rusefi/car-dash-wide/Hardware/photos/20230306_150623.jpg

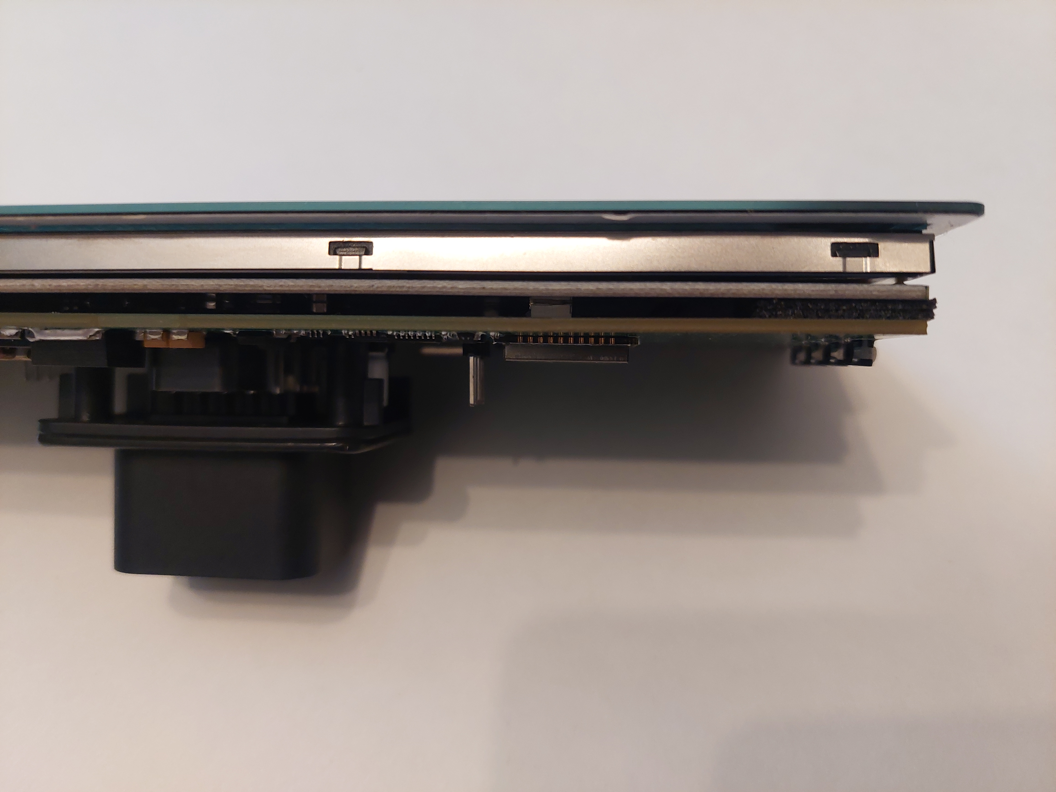
Hardware/photos/20230306_150623.jpg
