rusefi/car-dash-wide/README.md

# Digital Dash project using STM32F429II board with Surenoo 6.86" 480*1280 RGB Interface IPS LCD Module With Capacitive Touch Panel



Build on STM32CubeIDE 1.11.2 and TouchGFX 4.21.1

# Hardware

* STM32f429II
* SDRAM W9825G6KH-6I
* 2 CANBUS
* GPS ATGM336H-5N31
* ESP32-S3
* SD card
* 4 user buttons
* W2812 RGB LED connector
* on-board USB for debugging

# Initial Programming

[TC2030](https://github.com/rusefi/rusefi/wiki/Tag-Connect-TC2030) 

# Connector Part Numbers

[TE Connectivity 776262-1, 14 Contacts,  Male](https://www.mouser.co.uk/ProductDetail/TE-Connectivity/1-776262-1?qs=ZBKI5jzASZpOtA7SzySydw%3D%3D)

[TE Connectivity 776273-1, 14 Contacts,  Female](https://www.mouser.co.uk/ProductDetail/TE-Connectivity/776273-1?qs=VZ9FDhhp7SmYiN6cNJ9wsw%3D%3D)

[Datasheet](https://www.te.com/commerce/DocumentDelivery/DDEController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
)

# Connector pinout

Looking from the back of the dash

back

[Connector](https://opelpanfan.github.io/car-dash-wide/pinout/)
