rusefi/car-dash-wide/Firmware/TouchGFX/assets/images/race_dash_wide.png

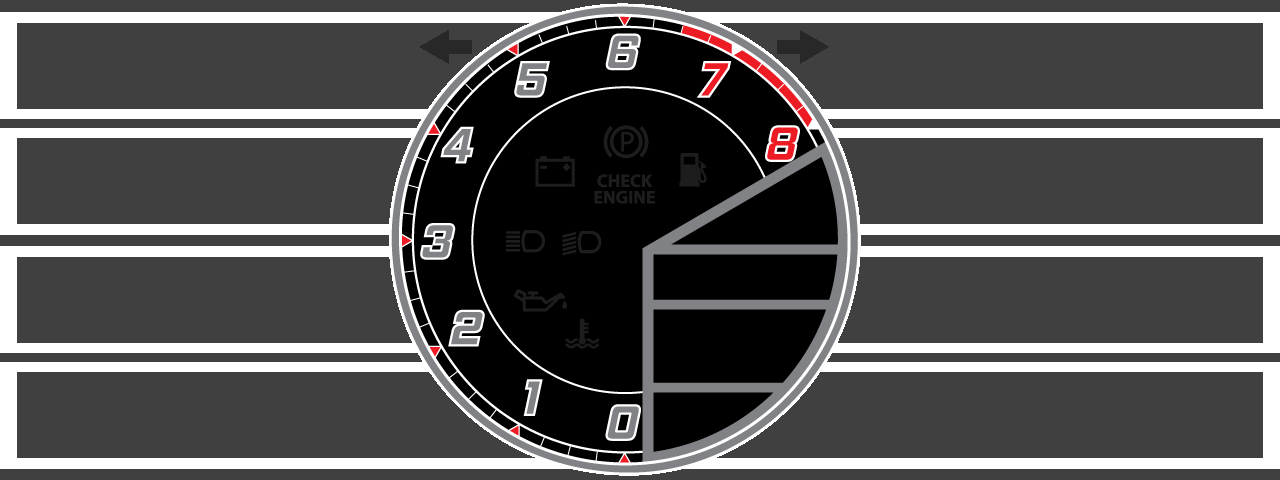
Firmware/TouchGFX/assets/images/race_dash_wide.png
