rusefi/car-dash-wide/Hardware/photos/20230228_181624.jpg

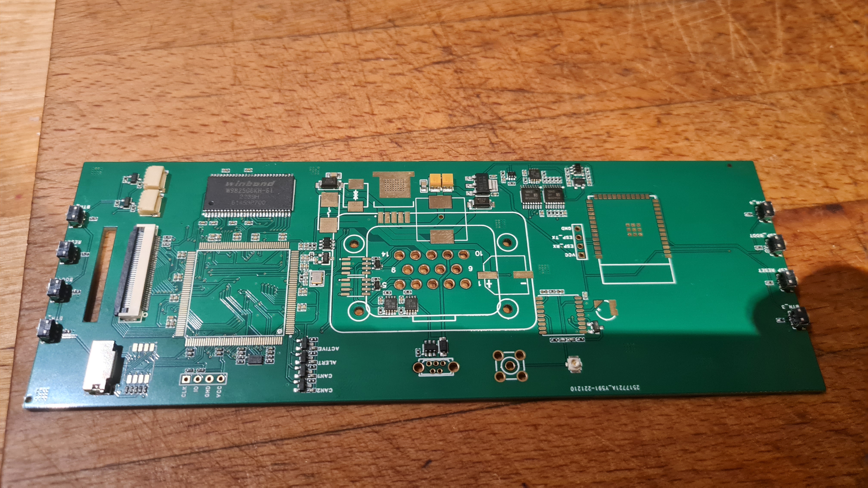
Hardware/photos/20230228_181624.jpg
