rusefi/car-dash-wide/Hardware/photos/20230228_181654.jpg

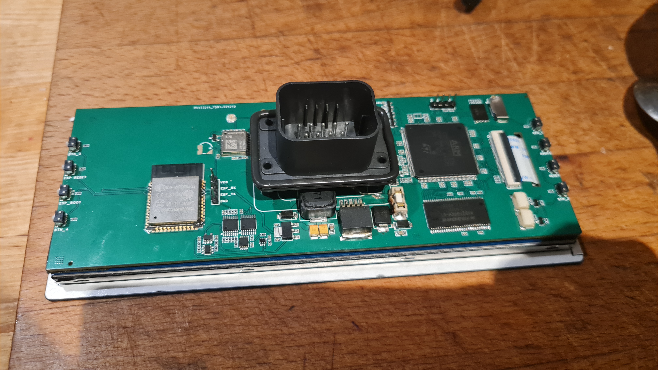
Hardware/photos/20230228_181654.jpg
