rusefi/car-dash-wide/Hardware/photos/20230228_181852.jpg

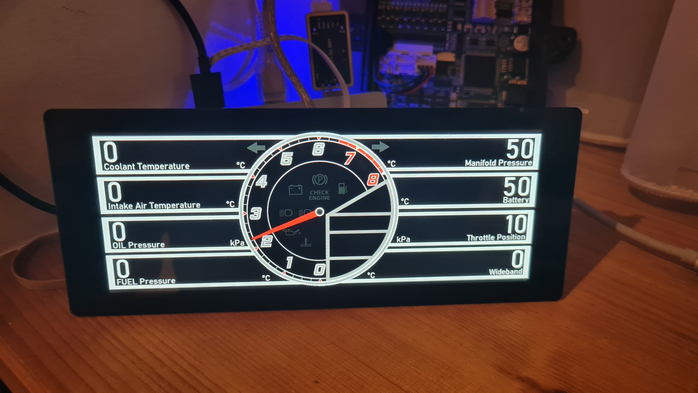
Hardware/photos/20230228_181852.jpg
