rusefi/car-dash-wide/Hardware/pinout/back.png

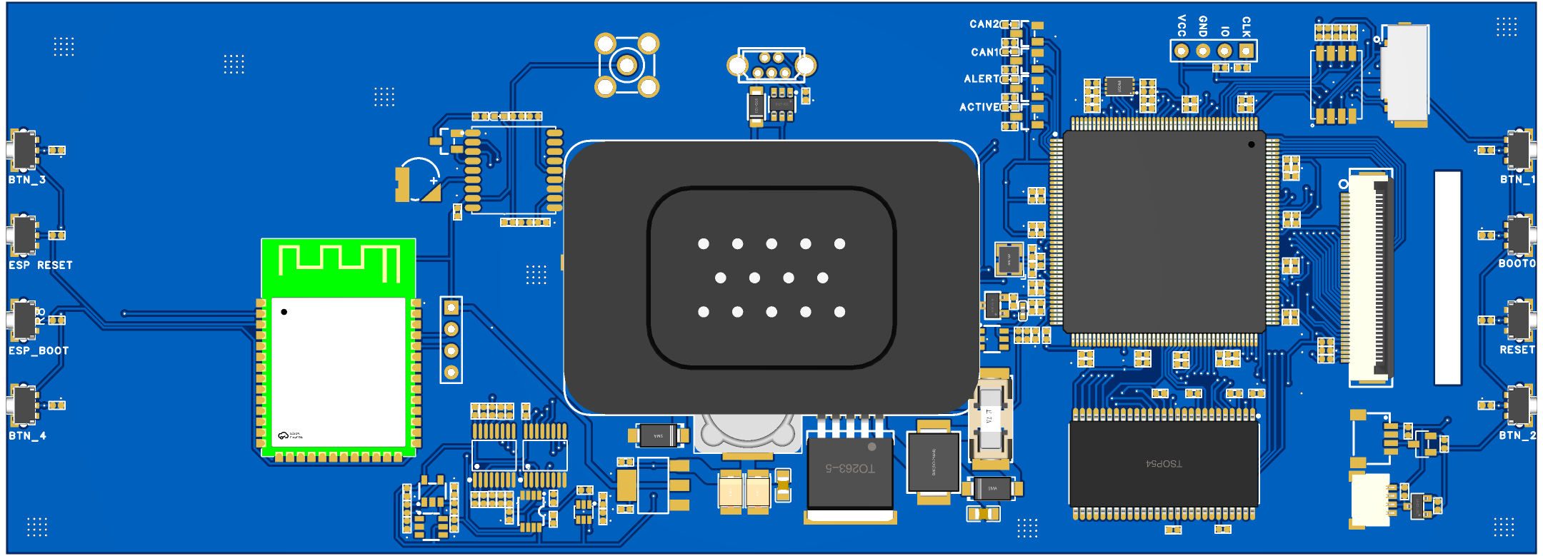
Hardware/pinout/back.png
