rusefi/car-dash-wide/Hardware/pinout/black14.jpg

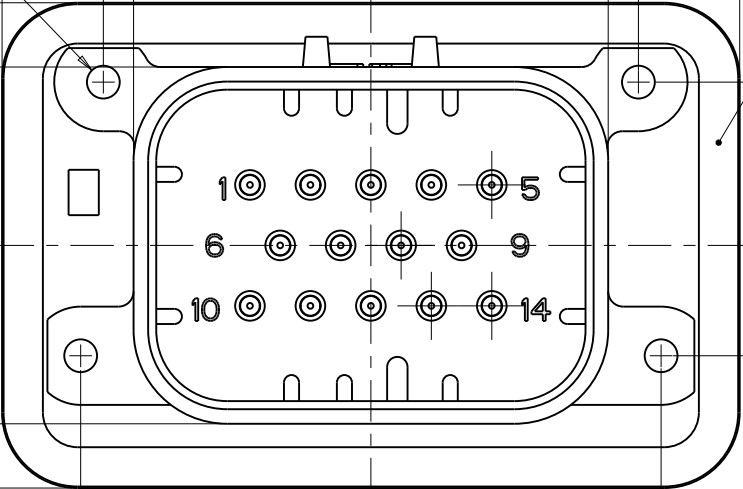
Hardware/pinout/black14.jpg
