rusefi/car-dash-wide/Hardware/export/0.1/BOM_STM32_DASH_2023-03-19.xlsx

No. | Quantity | Comment | Designator | Footprint | Value | Manufacturer Part | Manufacturer | Supplier | Supplier Part
1 | 2 | CAN03_TVS | 1,2 | SOT323_TVS |  |  |  | LCSC | C152727
2 | 2 | 100uF | C1,C10 | CAP-SMD_L3.5-W2.8 |  | TAJB107K006RNJ | AVX | LCSC | C16133
3 | 1 | 10uF | C2 | C_0402_1005METRIC |  | CL05A106MQ5NUNC | SAMSUNG | LCSC | C15525
4 | 14 | 100nF | C6,C15,C25,C38,C39,C40,C42,C49,C50,C52,C53,C56,C65,C103 | C_0402_1005METRIC |  | CL05B104KO5NNNC | SAMSUNG | LCSC | C1525
5 | 1 | 1nF | C17 | C_0402_1005METRIC |  | 0402B102K500NT | FH | LCSC | C1523
6 | 1 | 1uF | C29 | C0805 |  | CL21B105KBFNNNE | SAMSUNG | LCSC | C28323
7 | 1 | 100nF | C32 | C0805 |  | CC0805KRX7R9BB104 | YAGEO | LCSC | C49678
8 | 1 | 470uF | C33 | CAP-SMD_BD10.0-L10.3-W10.3-RD |  | VE-471M1E1010-TR0 | Lelon | LCSC | C249931
9 | 18 | 10nF | C34,C37,C47,C48,C59,C63,C64,C68,C73,C74,C75,C78,C84,C88,C91,C118,C123,C133 | C_0402_1005METRIC |  | CL05B103KB5NNNC | SAMSUNG | LCSC | C15195
10 | 17 | 4.7uF | C35,C66,C70,C71,C77,C79,C80,C81,C86,C87,C89,C127,C128,C129,C130,C131,C132 | C_0402_1005METRIC |  | CL05A475MP5NRNC | SAMSUNG | LCSC | C23733
11 | 2 | 20pF | C36,C72 | C_0402_1005METRIC |  | 0402CG200J500NT | FH | LCSC | C1554
12 | 2 | 2.2uF | C43,C44 | C_0402_1005METRIC |  | CL05A225MA5NUNC | SAMSUNG | LCSC | C159814
13 | 2 | 0 | C45,C46 | C_0402_1005METRIC |  | ?
14 | 1 | 1uF | C69 | C_0402_1005METRIC |  | CL05A105KA5NQNC | SAMSUNG | LCSC | C52923
15 | 1 | 33nF | C113 | C_0402_1005METRIC |  | 0402F333M500NT | FH | LCSC | C1585
16 | 1 | TF-021B-H265 | CARD2 | TF-SMD_TF-021B-H265 |  | TF-021B-H265 | SOFNG(硕方) | LCSC | C498185
17 | 2 | SM04B-SRSS-TB (LF)(SN) | CN1,CN2 | CONN-SMD_4P-P1.00_SM04B-SRSS-TB-LF-SN |  | SM04B-SRSS-TB (LF)(SN) | JST Sales America | LCSC | C160404
18 | 1 | 776262-1 | CN10 | CONN-TH_776262-1 |  | 776262-1 | TE Connectivity(美国泰科) | LCSC | C498489
19 | 1 | SM15T15CA | D2 | SMC_L6.9-W5.9-LS7.9-BI |  | SM15T15CA | STMicroelectronics | LCSC | C133713
20 | 2 | SS54_C22452 | D17,D20 | SMA_L4.4-W2.8-LS5.4-R-RD |  | SS54 | MDD | LCSC | C22452
21 | 1 | B5819W_C8598 | D23 | SOD-123_L2.8-W1.8-LS3.7-RD |  | B5819W | CJ | LCSC | C8598
22 | 1 | USBLC6-2SC6 | D24 | SOT-23-6_L2.9-W1.6-P0.95-LS2.8-BR |  | USBLC6-2SC6 | STMicroelectronics | LCSC | C7519
23 | 1 | 01550900M | FH1 | FUSE-SMD_L9.8-W5.0 |  | 01550900M | Littelfuse | LCSC | C108518
24 | 1 | LM1117IMPX-3.3 | IC3 | SOT223 |  |  |  | LCSC | C6186
25 | 1 | 470uH | L1 | IND-SMD_L12.5-W12.5 |  | SWRB1207S-471MT | Sunlord | LCSC | C397820
26 | 1 | 100Ω | L3 | L0402 |  | CBW100505U101T | FH | LCSC | C124089
27 | 1 | 47nH | L5 | R_0402_1005METRIC |  | SCC1005C47NJSP | Sunltech Tech | LCSC | C219549
28 | 5 | LED | LED1,LED2,LED3,LED4,LED28 | LED0402-RD |  |  |  | LCSC | C130722
29 | 2 | Header-Female-2.54_1x4 | P1,P3 | HDR-4X1/2.54 |  | Header-Female-2.54_1x4 | ReliaPro | LCSC | C124413
30 | 1 | FPCConnector 40PIN 0.5MM | P2 | FPC-SMD_40P-P0.50_FG-H2.0-40P |  | FPCConnector 40PIN 0.5MM | BOOMELE | LCSC | C9160
31 | 2 | BSS138_C400505 | Q1,Q2 | SOT-23-3_L2.9-W1.3-P1.90-LS2.4-BR |  | BSS138 | Yangzhou Yangjie Elec Tech | LCSC | C400505
32 | 1 | 0 | R1 | R_0402_1005METRIC |  | 0402WGF0000TCE | UniOhm | LCSC | C17168
33 | 36 | 10K | R2,R3,R4,R6,R7,R8,R9,R10,R12,R13,R15,R17,R18,R25,R26,R27,R28,R30,R32,R34,R35,R36,R37,R39,R40,R42,R44,R47,R127,R136,R137,R158,R205,R254,R256,R257 | R_0402_1005METRIC |  | 0402WGF1002TCE | UniOhm | LCSC | C25744
34 | 1 | 6.34K | R11 | R_0402_1005METRIC |  | 0402WGF6341TCE | UniOhm | LCSC | C45013
35 | 5 | 1K | R14,R41,R45,R46,R48 | R_0402_1005METRIC |  | 0402WGF1001TCE | UniOhm | LCSC | C11702
36 | 2 | 1M | R16,R23 | R_0402_1005METRIC |  | MCHVR02FTEY1004 | Multicomp | LCSC | C241267
37 | 5 | 4.7K | R19,R20,R21,R22,R24 | R_0402_1005METRIC |  |  |  | LCSC | C25900
38 | 1 | 10 | R29 | R_0402_1005METRIC |  | ? |  |  | C25077
39 | 2 | 120 | R31,R33 | R_0402_1005METRIC |  | 0402WGF1200TCE | UniOhm | LCSC | C25079
40 | 1 | 39 | R38 | R_0402_1005METRIC |  | 0402WGF390JTCE | UniOhm | LCSC | C25110
41 | 1 | 2.49K | R43 | R_0402_1005METRIC |  | 0402WGF2491TCE | UniOhm | LCSC | C25884
42 | 1 | 100K | R58 | R_0402_1005METRIC |  | RC0402FR-07100KL | YAGEO | LCSC | C60491
43 | 1 | 3.3K | R149 | R_0402_1005METRIC |  | 0402WGF3301TCE | UniOhm | LCSC | C25890
44 | 1 | 470K | R170 | R_0402_1005METRIC |  | 0402WGF4703TCE | UniOhm | LCSC | C25790
45 | 1 | 5.6K | R185 | R_0402_1005METRIC |  | 0402WGF5601TCE | UniOhm | LCSC | C25908
46 | 8 | SKRTLAE010 | SW2,SW3,SW4,SW5,SW6,SW7,SW8,SW9 | KEY-SMD_SKRTLAE010 |  | SKRTLAE010 | ALPSALPINE(阿尔卑斯阿尔派) | LCSC | C110293
47 | 2 | SRV05-4-P-T7 | TV1,TV5 | SOT-23-6_L2.9-W1.6-P0.95-LS2.8-BR |  | SRV05-4-P-T7 | PROTEK | LCSC | C85364
48 | 1 | XTSD04GCLGEGA | U1 | LGA-8_L6.0-W8.0-P1.27-TL |  | XTSD04GCLGEGA | XTX(芯天下) | LCSC | C2759953
49 | 1 | 74HC2G17GW,125 | U2 | SOT-363_L2.0-W1.3-P0.65-LS2.1-BR |  | 74HC2G17GW,125 | Nexperia | LCSC | C94189
50 | 2 | CD4051BPWR | U3,U12 | TSSOP-16_L5.0-W4.4-P0.65-LS6.4-BL |  | CD4051BPWR | TI | LCSC | C54587
51 | 1 | LM2596SX-5.0/NOPB | U4 | TO-263-5_L10.2-W8.9-P1.70-TL |  | LM2596SX-5.0/NOPB | TI | LCSC | C10002
52 | 3 | 74LVC1G53DP,125 | U5,U6,U16 | TSSOP-8_L3.0-W3.0-P0.65-LS4.0-BL |  | 74LVC1G53DP,125 | Nexperia | LCSC | C548378
53 | 1 | REF3033AIDBZR | U7 | SOT-23-3_L3.0-W1.7-P0.95-LS2.9-BR |  | REF3033AIDBZR | TI | LCSC | C36658
54 | 1 | MCP6001T-I/OT | U8 | SOT-23-5_L3.0-W1.7-P0.95-LS2.8-BR |  | MCP6001T-I/OT | MICROCHIP | LCSC | C116490
55 | 1 | 5-1814832-1 | U9 | RF-TH_5-1814832-1 |  | 5-1814832-1 | TE Connectivity | LCSC | C127838
56 | 1 | W9825G6KH-6I | U10 | TSOP-54_L22.2-W10.2-P0.80-LS11.8-BL |  | W9825G6KH-6I | WINBOND | LCSC | C97572
57 | 1 | SM3R3703T01U | U13 | CAP-SMD_2P-L4.8-W4.8-TR |  | SM3R3703T01U | KORCHIP(高奇普) | LCSC | C396469
58 | 2 | SN65HVD230QDR | U19,U20 | SOIC127P600X175-8N |  |  |  | LCSC | C12084
59 | 1 | STM32F429IIT6 | U22 | LQFP-176_L24.0-W24.0-P0.50-BL |  | STM32F429IIT6 | ST(意法半导体) | LCSC | C75389
60 | 1 | ATGM336H-5N31 | U31 | GPSM-SMD_ATGM336H-TR |  | ATGM336H-5N31 | ZHONGKEWEI | LCSC | C90770
61 | 1 | ESP32-S3-WROOM-1-N8 | U36 | WIFIM-SMD_ESP32-S3-WROOM-1-N8 |  | ESP32-S3-WROOM-1-N8 | ESPRESSIF(乐鑫) | LCSC | C2913198
62 | 1 | W25Q16FWUXIE | U43 | USON8_L2.0-W3.0-P0.50-BL-EP |  | W25Q16FWUXIE | WINBOND(华邦) | LCSC | C401672
63 | 5 | LMUN2211LT1G | VT1,VT2,VT3,VT4,VT14 | SOT-23-3_L2.9-W1.3-P1.90-LS2.4-BR |  | LMUN2211LT1G | LRC | LCSC | C12775
64 | 1 | 12MHz | X1 | OSC-SMD_4P-L3.2-W2.5-BL |  | X322512MSB4SI | YXC | LCSC | C9002
