rusefi/car-dash-wide/Hardware/export/0.1/SCH_6.86 DASH SCH_2023-02-28.pdf

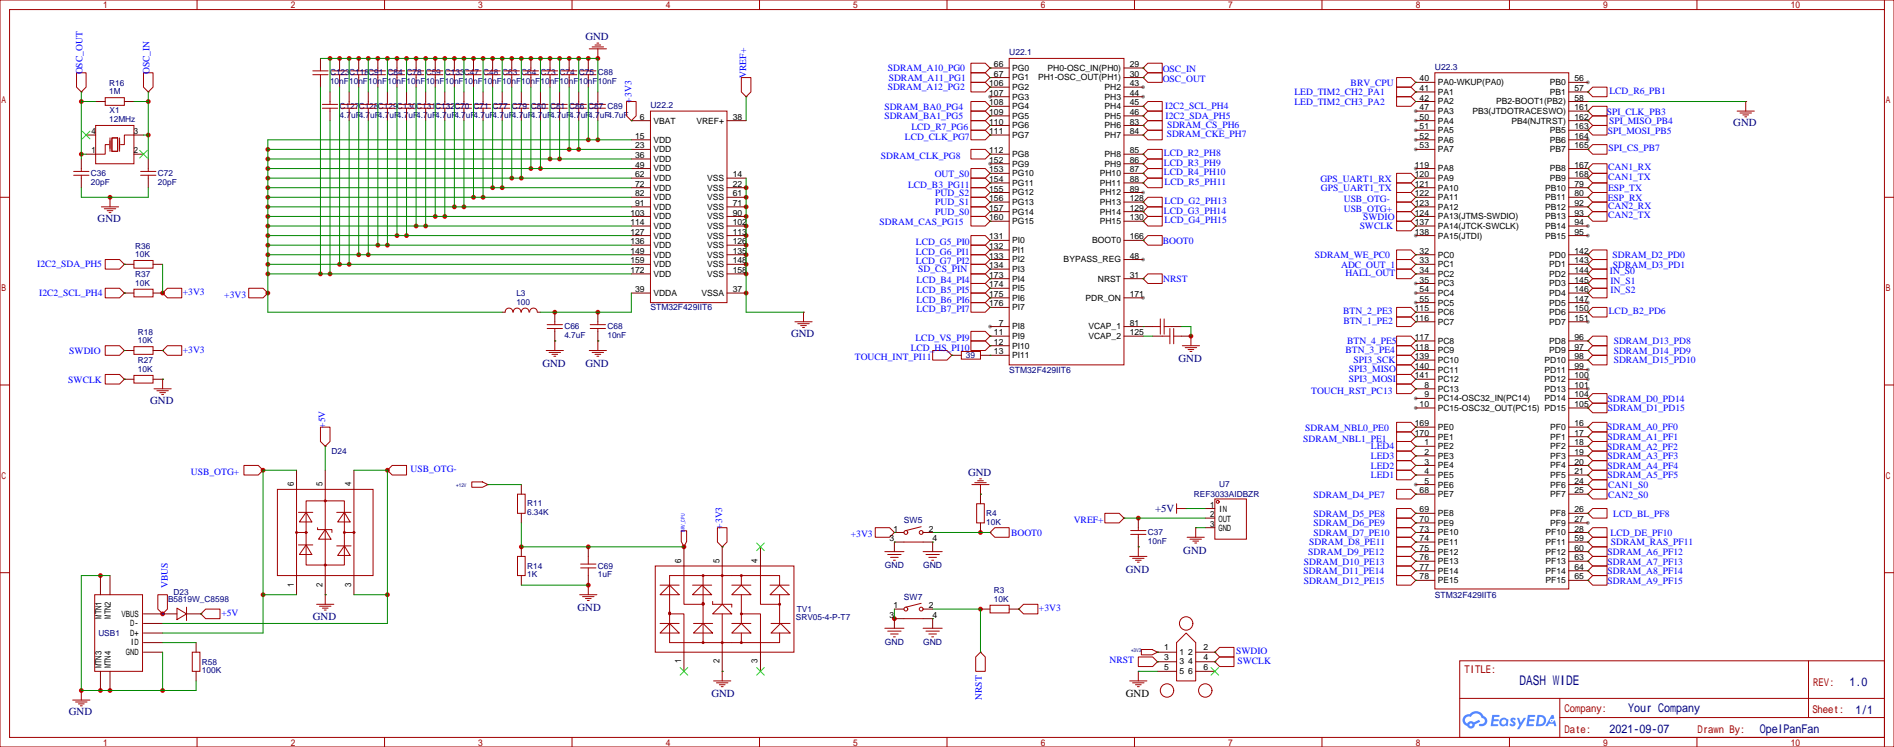
[picture p11: page 1]

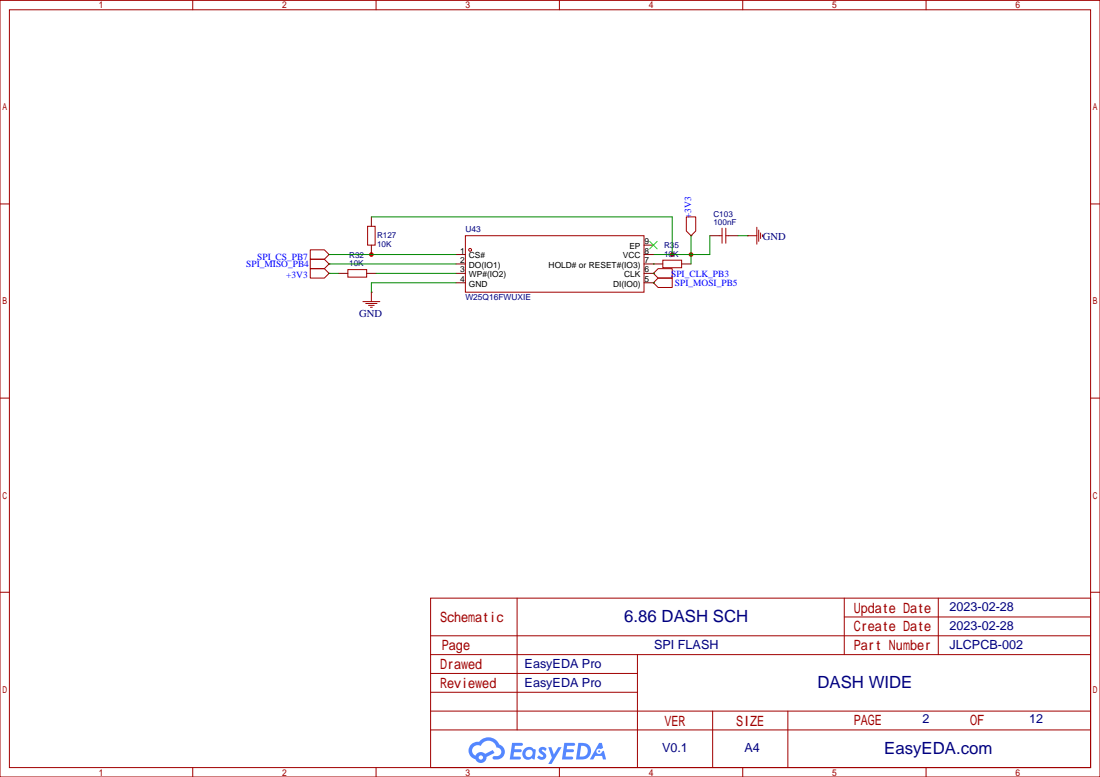
[picture p12: page 2]

IO0 27 IO35 28 IO36 29 IO37 30 IO38 31 IO39 32 IO40 33 IO41 34 IO42 35 RXD0 36 TXD0 37 IO2 38 IO1 39 GND 40

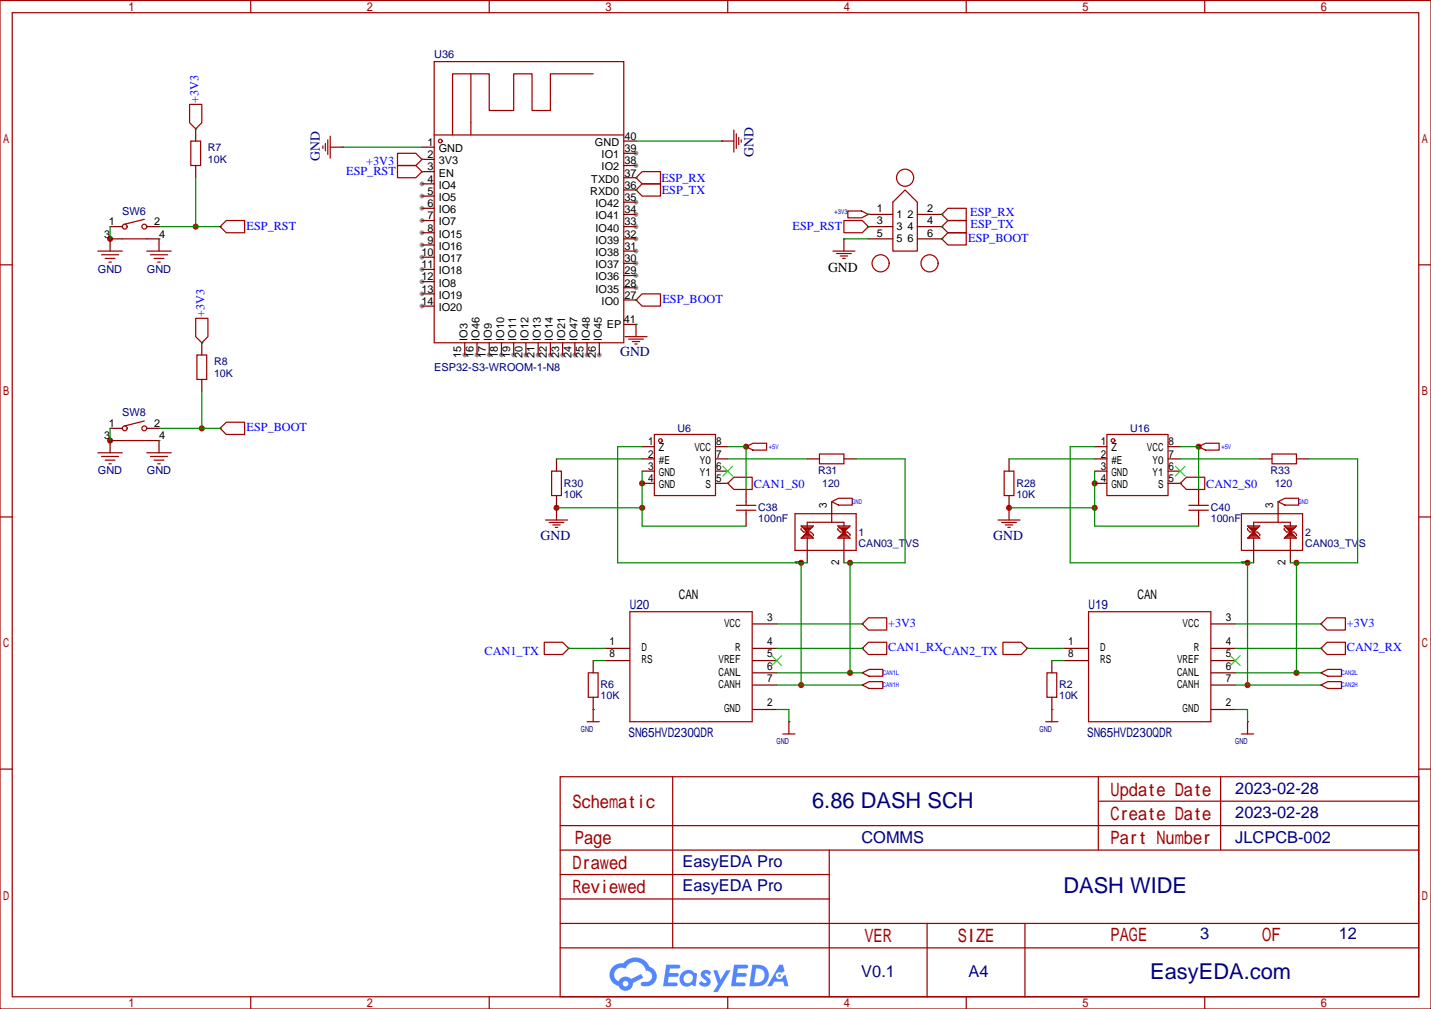
[picture p13: page 3]

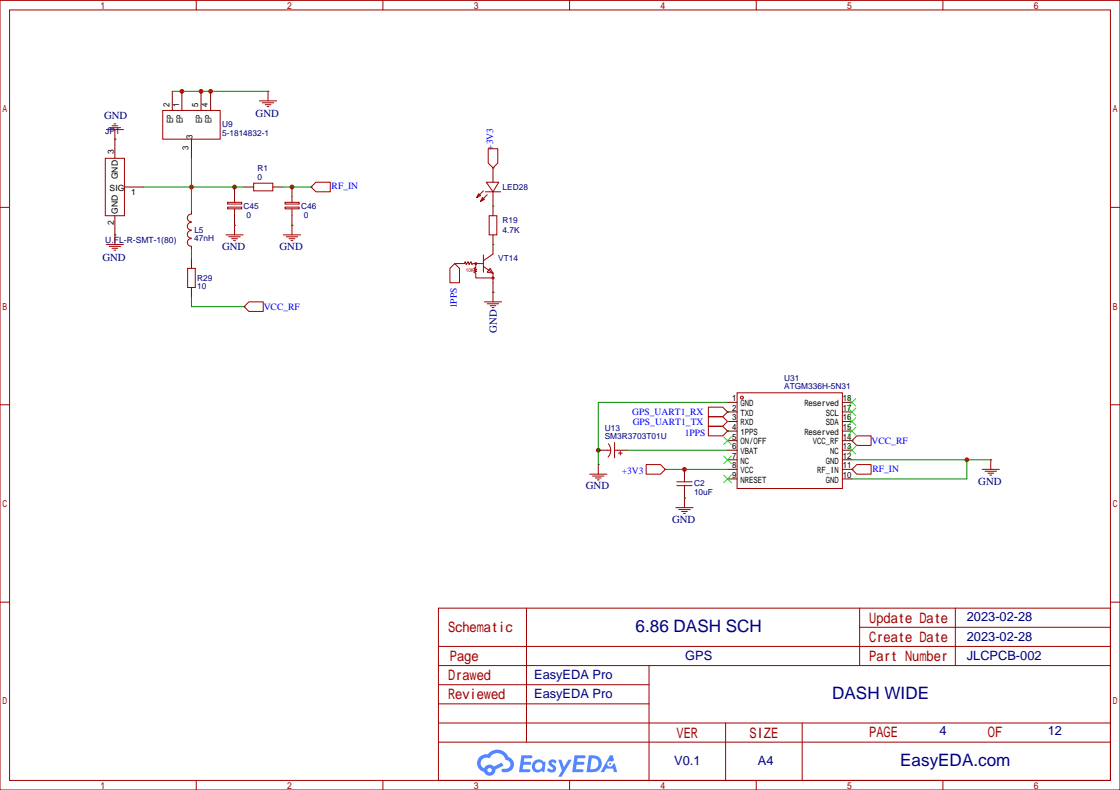
[picture p14: page 4]

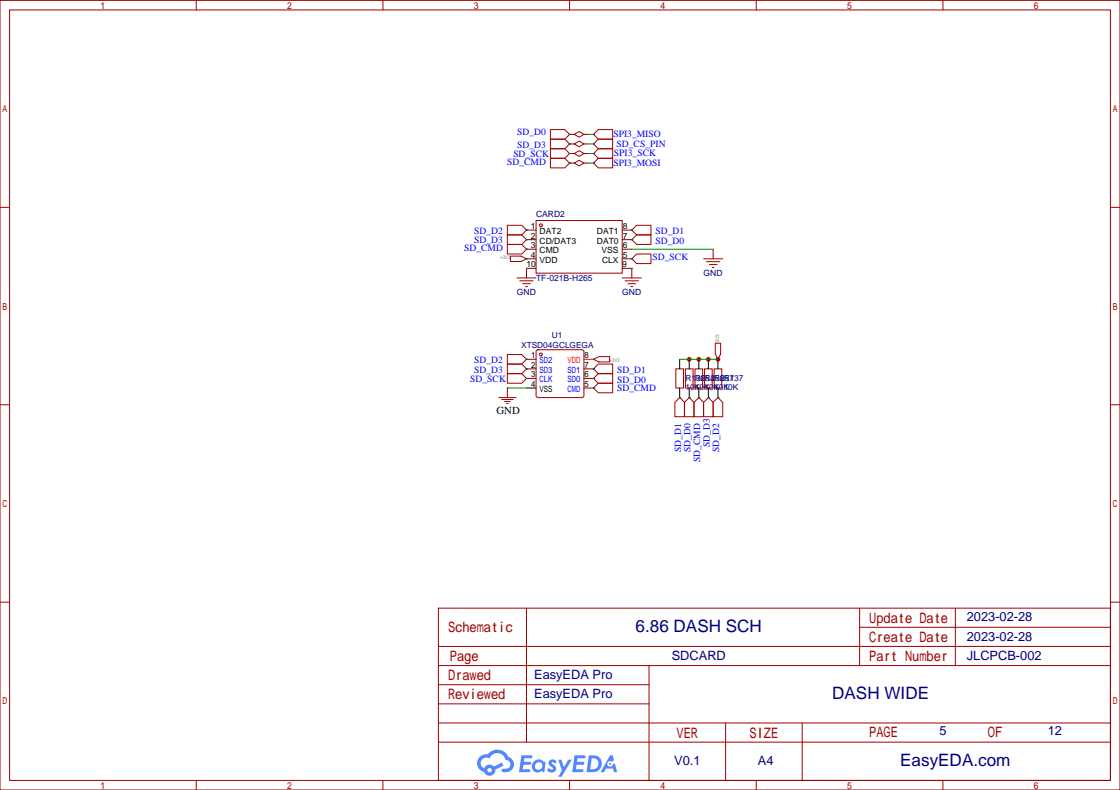
[picture p15: page 5]

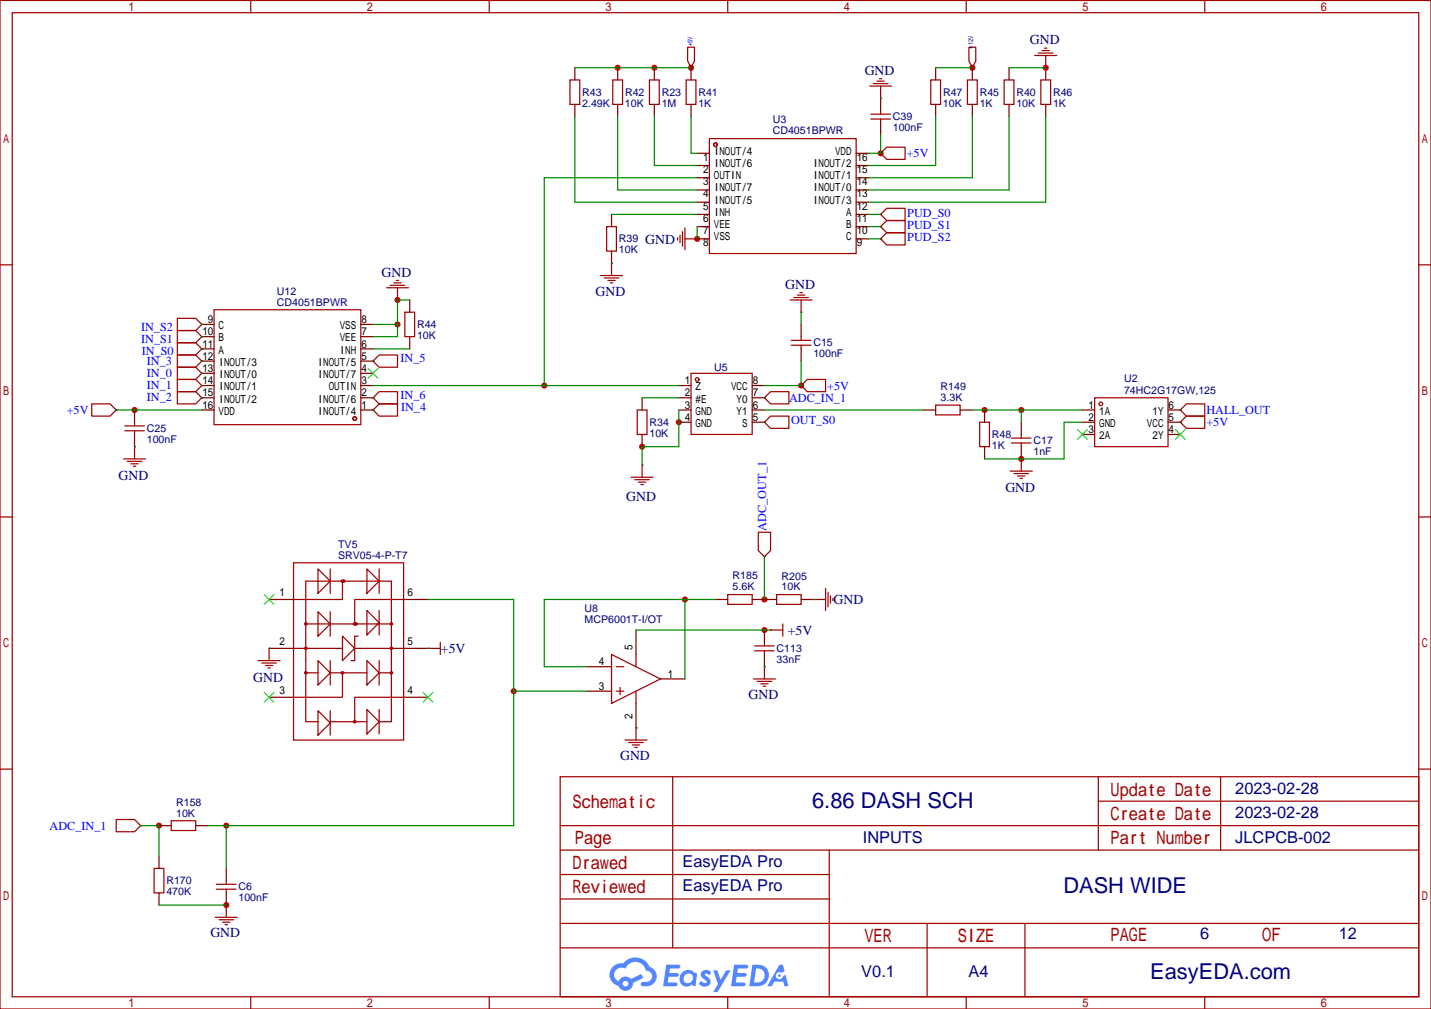
[picture p16: page 6]

# +3V3 +³V³

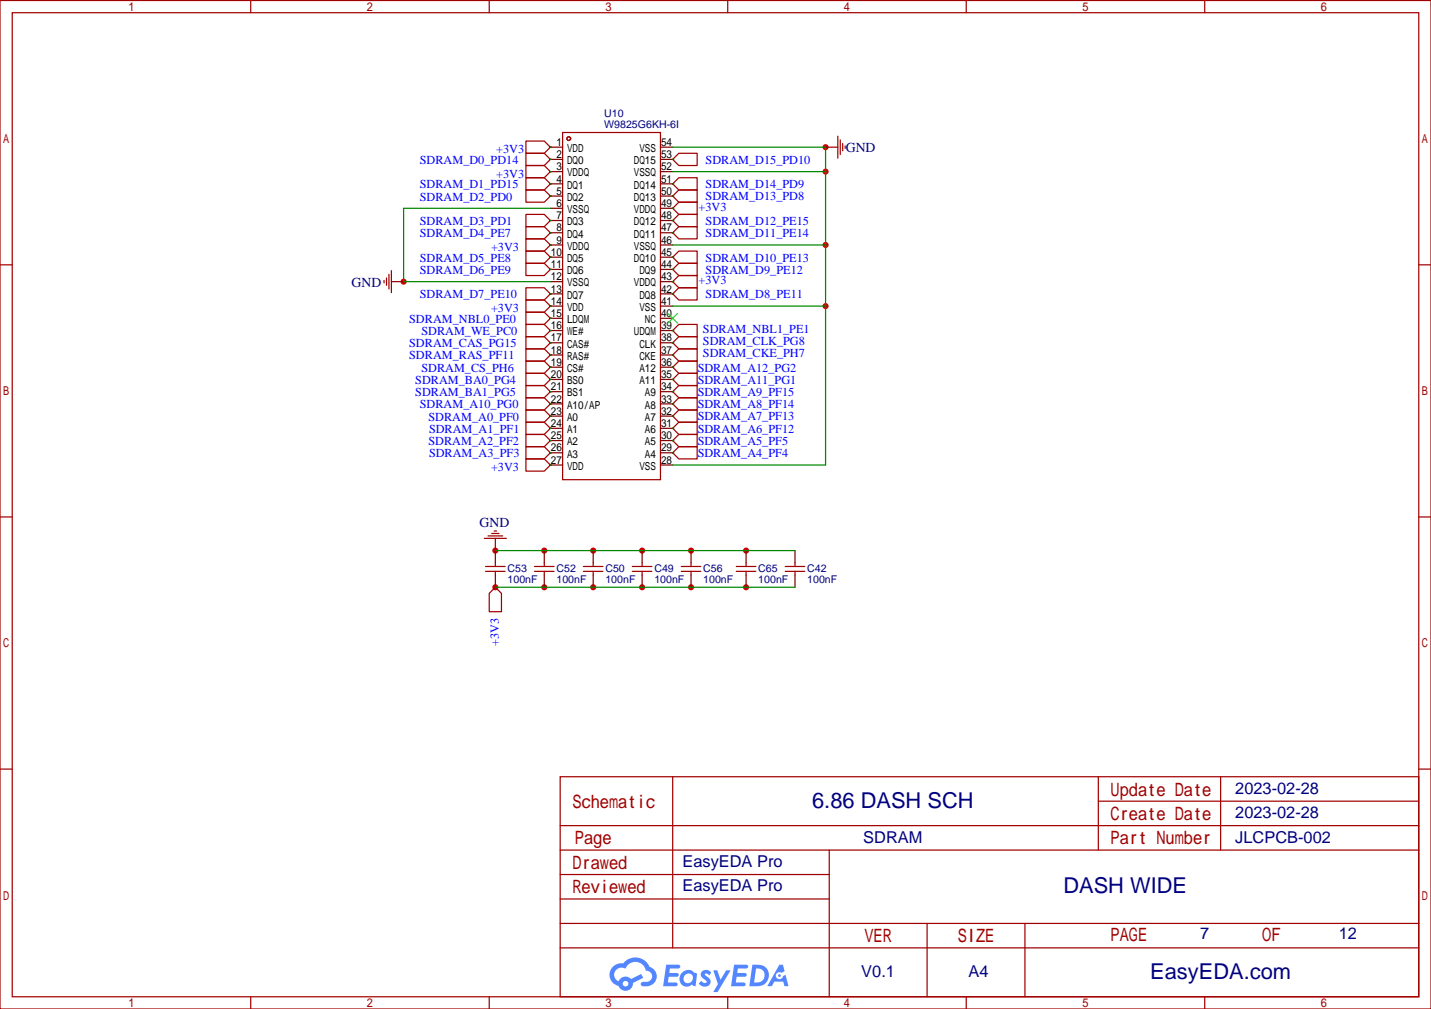
[picture p17: page 7]

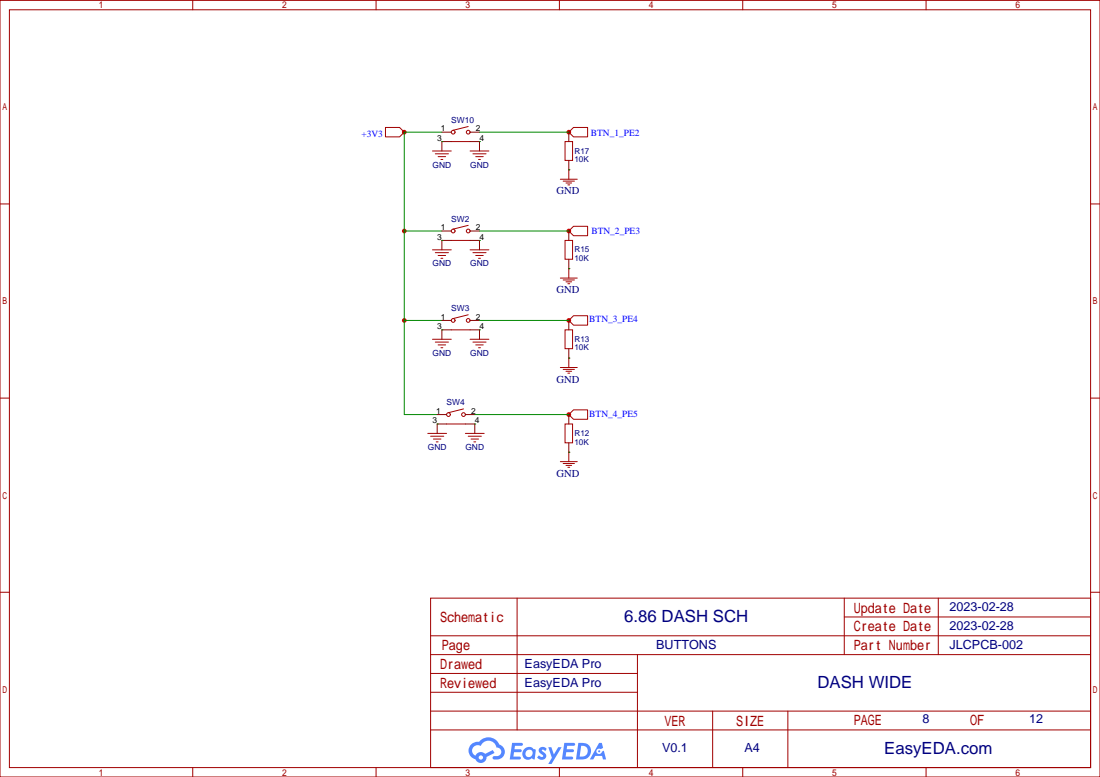
[picture p18: page 8]

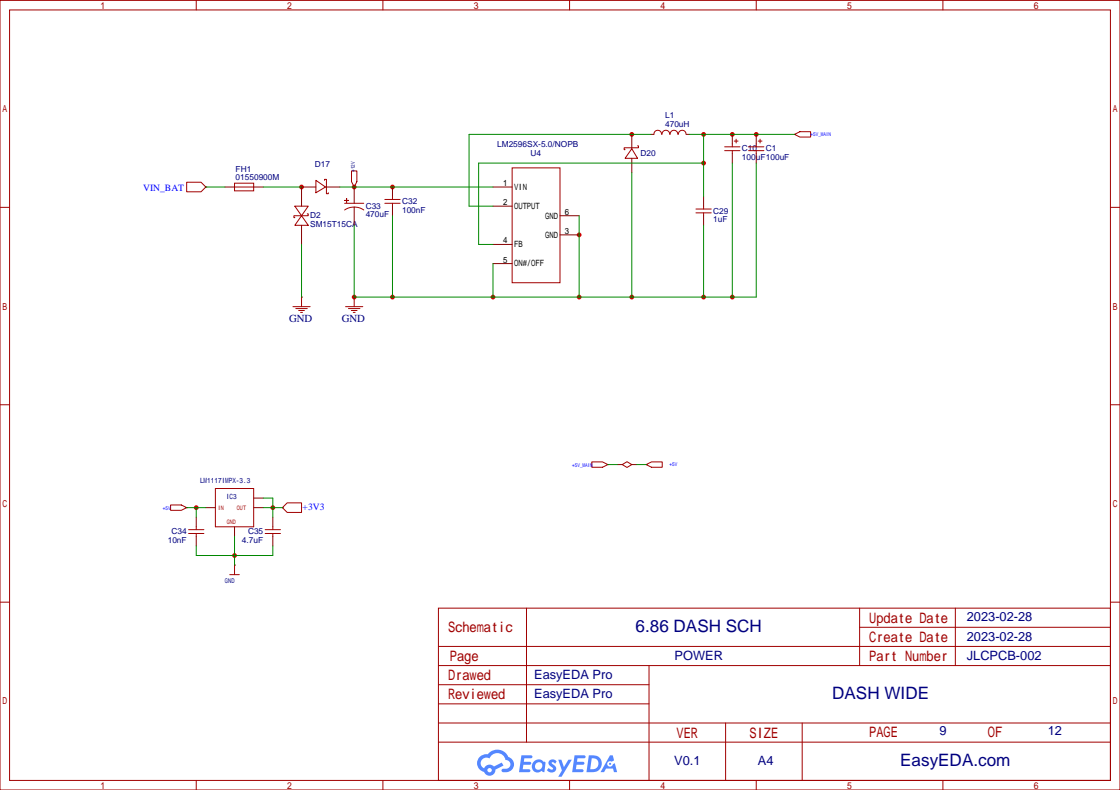
[picture p19: page 9]

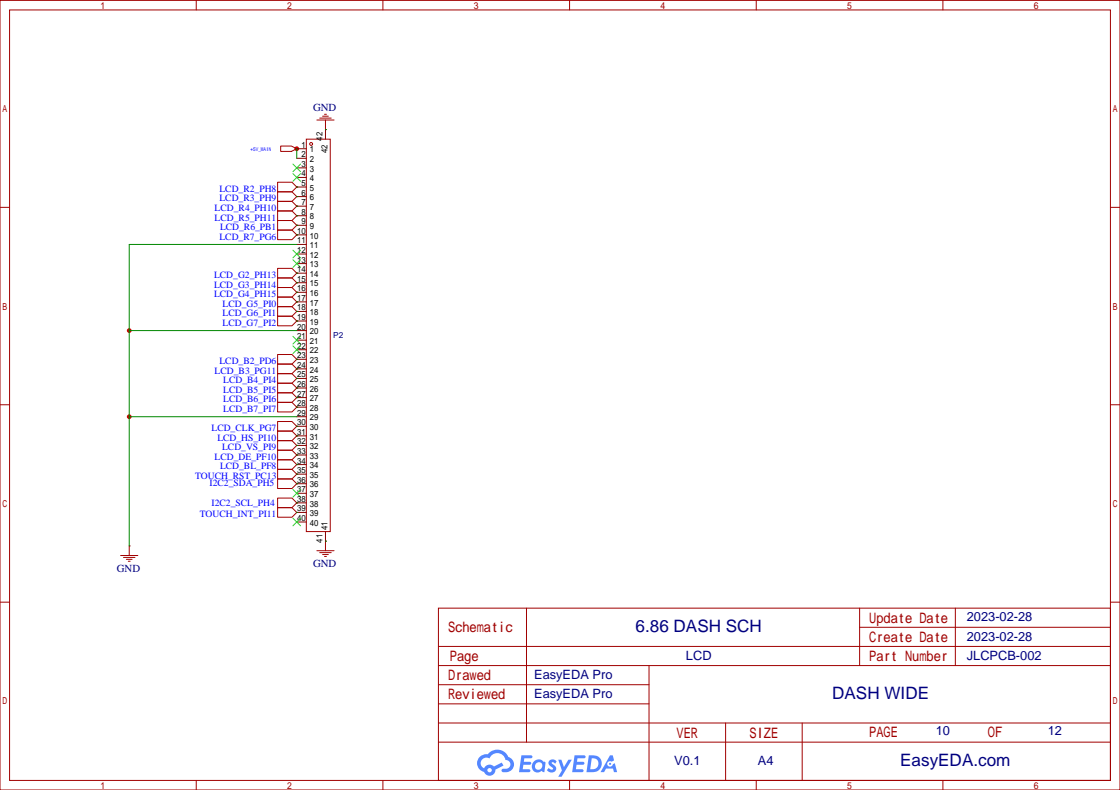
[picture p20: page 10]

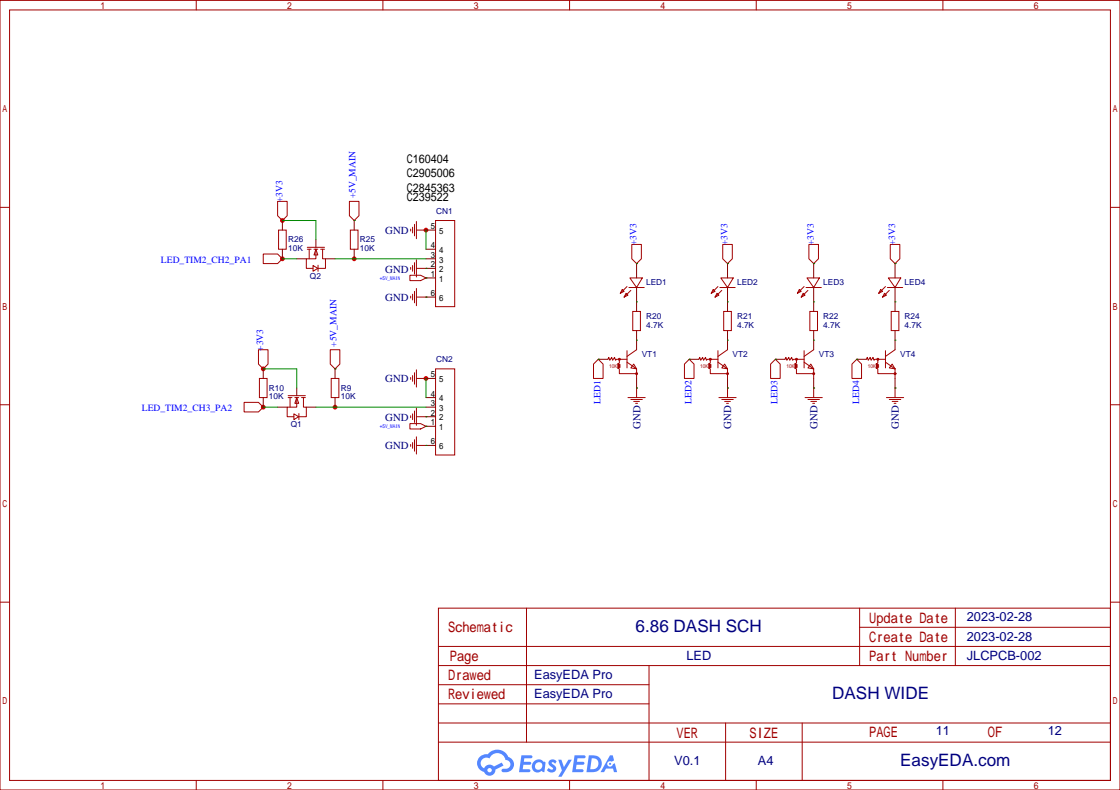
[picture p21: page 11]

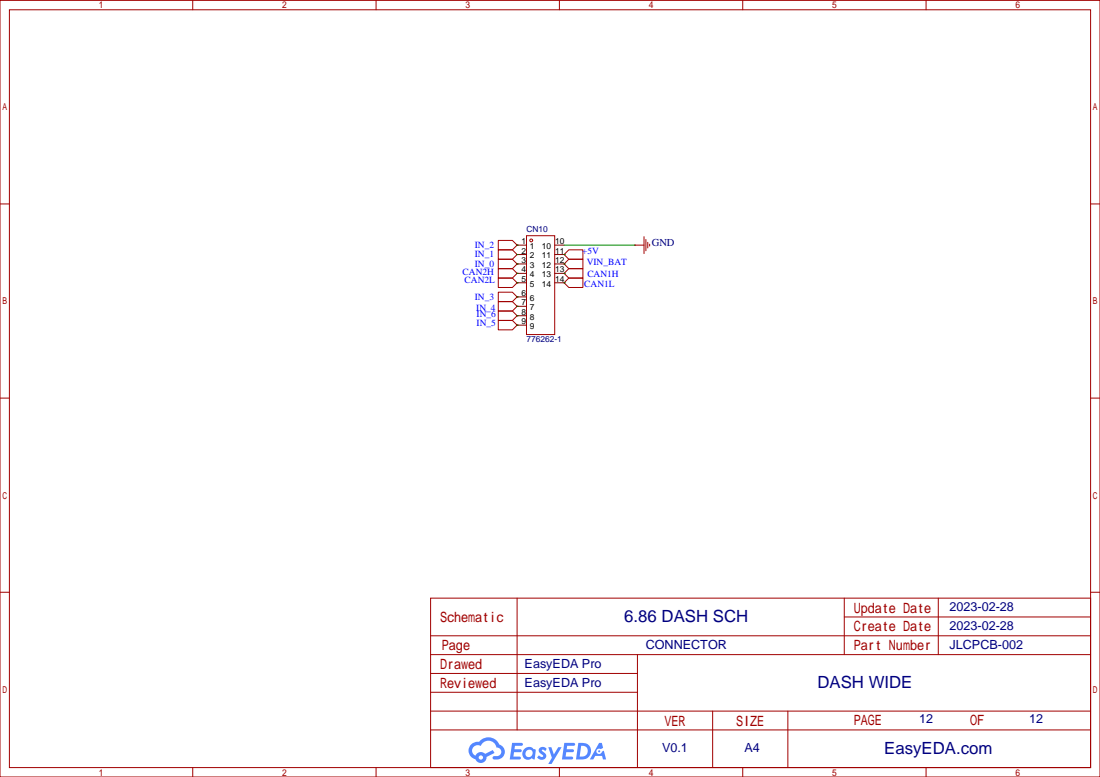
[picture p22: page 12]
