rusefi/car-dash-wide/Firmware/Core/Inc/sdram.h

#ifndef  __SDRAM_H
#define	__SDRAM_H

#include "stm32f4xx_hal.h"

#define SDRAM_Size 0x01000000
#define SDRAM_BANK_ADDR     ((uint32_t)0xD0000000)ݻ���ַ
#define FMC_COMMAND_TARGET_BANK   FMC_SDRAM_CMD_TARGET_BANK2
#define SDRAM_TIMEOUT     ((uint32_t)0x1000)

#define SDRAM_MODEREG_BURST_LENGTH_1             ((uint16_t)0x0000)
#define SDRAM_MODEREG_BURST_LENGTH_2             ((uint16_t)0x0001)
#define SDRAM_MODEREG_BURST_LENGTH_4             ((uint16_t)0x0002)
#define SDRAM_MODEREG_BURST_LENGTH_8             ((uint16_t)0x0004)
#define SDRAM_MODEREG_BURST_TYPE_SEQUENTIAL      ((uint16_t)0x0000)
#define SDRAM_MODEREG_BURST_TYPE_INTERLEAVED     ((uint16_t)0x0008)
#define SDRAM_MODEREG_CAS_LATENCY_2              ((uint16_t)0x0020)
#define SDRAM_MODEREG_CAS_LATENCY_3              ((uint16_t)0x0030)
#define SDRAM_MODEREG_OPERATING_MODE_STANDARD    ((uint16_t)0x0000)
#define SDRAM_MODEREG_WRITEBURST_MODE_PROGRAMMED ((uint16_t)0x0000) 
#define SDRAM_MODEREG_WRITEBURST_MODE_SINGLE     ((uint16_t)0x0200) 


void SDRAM_delay(__IO uint32_t nCount);
HAL_StatusTypeDef SDRAM_Initialization_Sequence(SDRAM_HandleTypeDef *hsdram, FMC_SDRAM_CommandTypeDef *Command);

#endif //__SDRAM_H
