rusefi/car-dash-wide/Firmware/Core/Src/sdram.c

#include "sdram.h"   

SDRAM_HandleTypeDef hsdram1;
FMC_SDRAM_CommandTypeDef command;

void SDRAM_delay(__IO uint32_t nCount)
{
  __IO uint32_t index = 0; 
	
  for(index = (100000 * nCount); index != 0; index--);

}


HAL_StatusTypeDef SDRAM_Initialization_Sequence(SDRAM_HandleTypeDef *hsdram, FMC_SDRAM_CommandTypeDef *Command)
{
	HAL_StatusTypeDef status = HAL_OK;
  __IO uint32_t tmpmrd = 0;
  
  /* Configure a clock configuration enable command */
  Command->CommandMode 					= FMC_SDRAM_CMD_CLK_ENABLE;
  Command->CommandTarget 				= FMC_COMMAND_TARGET_BANK;
  Command->AutoRefreshNumber 			= 1;
  Command->ModeRegisterDefinition 	= 0;
  
  status = HAL_SDRAM_SendCommand(hsdram, Command, SDRAM_TIMEOUT);
  SDRAM_delay(1);
  
  /* Configure a PALL (precharge all) command */ 
  Command->CommandMode 					= FMC_SDRAM_CMD_PALL;
  Command->CommandTarget 				= FMC_COMMAND_TARGET_BANK;
  Command->AutoRefreshNumber 			= 1;
  Command->ModeRegisterDefinition 	= 0;
  
  status = HAL_SDRAM_SendCommand(hsdram, Command, SDRAM_TIMEOUT);
  
  /* Configure a Auto-Refresh command */ 
  Command->CommandMode 					= FMC_SDRAM_CMD_AUTOREFRESH_MODE;
  Command->CommandTarget 				= FMC_COMMAND_TARGET_BANK;
  Command->AutoRefreshNumber			= 8;
  Command->ModeRegisterDefinition 	= 0;
  
  status = HAL_SDRAM_SendCommand(hsdram, Command, SDRAM_TIMEOUT);
  
  /* Program the external memory mode register */
  tmpmrd = (uint32_t)SDRAM_MODEREG_BURST_LENGTH_2          |
                     SDRAM_MODEREG_BURST_TYPE_SEQUENTIAL   |
                     SDRAM_MODEREG_CAS_LATENCY_3           |
                     SDRAM_MODEREG_OPERATING_MODE_STANDARD |
                     SDRAM_MODEREG_WRITEBURST_MODE_SINGLE;
  
  Command->CommandMode					= FMC_SDRAM_CMD_LOAD_MODE;
  Command->CommandTarget 				= FMC_COMMAND_TARGET_BANK;
  Command->AutoRefreshNumber 			= 1;
  Command->ModeRegisterDefinition 	= tmpmrd;
  
  status = HAL_SDRAM_SendCommand(hsdram, Command, SDRAM_TIMEOUT);
  
  hsdram->Instance->SDRTR |= ((uint32_t)((1386)<< 1));

  return status;
}
