rusefi/car-dash-wide/(commit log)

2021-07-19 working V1
    [texts.xlsx]
2022-01-19 Full screen and working canbus
2023-03-07 added test PCD EasyEda project (2 layers, small buttons)
2023-03-09 connector spelling mistake
2023-03-15 ws2812 rgb driver
2023-03-19 production files
    [BOM_STM32_DASH_2023-03-19.xlsx, PickAndPlace_STM32_DASH_2023-03-19.xlsx]
2023-04-05 WS2812 DMA driver added and RPM Shift limiter
2023-04-07 Updated WS2812 driver to control manualy when buffer is transfered to DMA, enabled CAN as well
