rusefi/car-dash-wide/Hardware/photos/20230306_150544.jpg

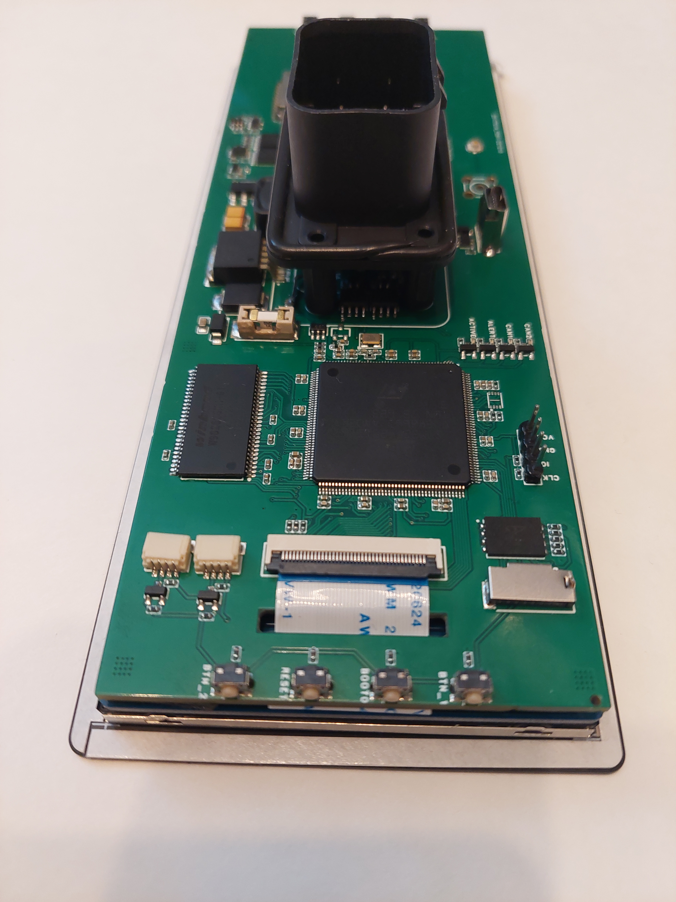
Hardware/photos/20230306_150544.jpg
