rusefi/car-dash-wide/Hardware/photos/20230306_150554.jpg

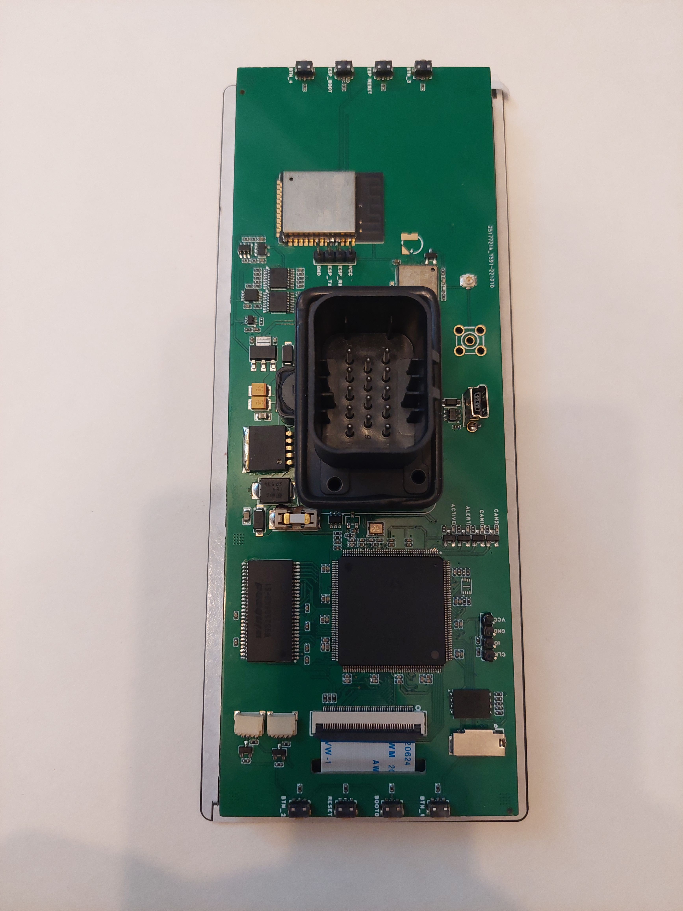
Hardware/photos/20230306_150554.jpg
