rusefi/car-dash-wide/Hardware/photos/20230306_150605.jpg

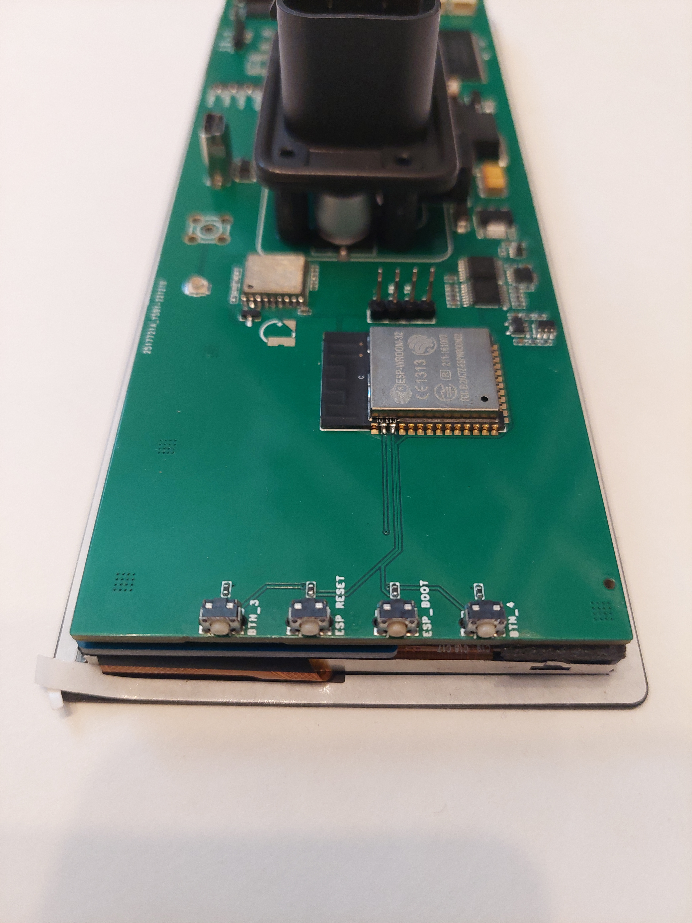
Hardware/photos/20230306_150605.jpg
